atsju/capacitiveChess_HW/BOM/20210901_BOM_Capacitive chessboard.xlsx

Item | Designator | Quantity | Manufacturer | Part number | Description | Footprint | Type | Remark
1 | B1 | 1 | Keystone | 2468 | 2AAA battery holder | Non-standard | THD
2 | S129 | 1 | E-Switch | EG1206A | switch | Non-standard | THD
3 | S130, S131, S132, S133, S134 | 5 | Diptronics | DTS-62N-V | 6x6mm tact switch. Switch Push Button OFF (ON) SPST Round Button Momentary Contact PC Pins Thru-Hole | 6x6mm tact switch | THD | Assembly house often need part number for this even if it’s very common part. Just pick cheap one or with button head color/length you want.
4 | J1 | 1 | Amphenol ICC / FCI | 10118193-0001LF | FCI Right Angle Surface Mount Mount Female USB Connector; 100 V ac; 1.8A | Non-standard | SMD/THD
5 | C1, C2, C3, C4, C5, C6, C7, C8, C9, C10, C11, C12, C13, C14, C15, C16, C20, C23, C24, C25, C26, C27, C28, C33, C53, C54, C55, C56, C57, C59, C60 | 31 | - | 100nF | 0402 100nF 6.3V X5R | 0402 | SMD
6 | C17, C18, C21 | 3 | - | 1uF | 0603 1uF 10V X5R | 0603 | SMD
7 | C19 | 1 | - | 100uF | 1206 100uF 6.3V X5R | 1206 | SMD
8 | C29, C31 | 2 | - | 4.7uF | 0603 4.7uF 6.3V X5R | 0603 | SMD
9 | C30, C34, C61 | 3 | - | 10uF | 0603 10uF 6.3V X5R | 0603 | SMD
10 | C32 | 1 | - | 22pF | 0402 22pF 6.3V C0G | 0402 | SMD
11 | C35, C36 | 2 | - | 1nF | 0402 1nF 6.3V X5R | 0402 | SMD
12 | D1, D2, D3, D4, D5, D6, D7, D8, D9, D10, D11, D12, D13, D14, D15, D16, D17, D18, D19, D20, D21, D22, D23, D24, D25, D26, D27, D28, D29, D30, D31, D32, D33, D34, D35, D36, D37, D38, D39, D40, D41, D42, D43, D44, D45, D46, D47, D48, D49, D50, D51, D52, D53, D54, D55, D56, D57, D58, D59, D60, D61, D62, D63, D64, D65, D66, D67, D68, D69, D70, D71, D72, D73, D74, D75, D76, D77, D78, D79, D80, D81 | 81 | Lite-On | LTST-C230KRKT | bottom view LED Min distance is 2.2mm. Drill 2.4mm | 1206 | SMD | Requires manual drilling at home before mounting. Fab house will not assembly this for you with V0 PCB.
13 | D83 | 1 | Rohm | RSX051VAM30TR | Schottky diode, Vf<0.25V@10mA/25°C Vrrm>25V | SOD-323HE | SMD
14 | J2 | 1 | Amphenol ICC / FCI | SFV10R-1STBE1HLF | Conn FFC/FPC Connector SKT 10 POS 0.5mm Solder RA SMD Embossed T/R | Non-standard | SMD
15 | L1 | 1 | Bourns | SRN4026-4R7M | 4.7uH DCR<0.1R Isat>0.8A 4x4mm | 4x4mm | SMD
16 | L2 | 1 | Bourns | SRN4018-2R2M | 2.2uH DCR<0.1R Isat>0.4A 4x4mm | 4x4mm | SMD
17 | R65, R67 | 2 | - | 10k | 0402 10k 1 % | 0402 | SMD
18 | R49, R50, R51, R52, R53, R54, R55, R56, R57, R71 | 10 | - | 1k | 0402 1k 1% | 0402 | SMD | Value on LED lines can be adjusted to change brightness
19 | R58, R62, SB20, SB21, SB22, SB23, SB28, SB29, SB30, SB31, SB36, SB37, SB38, SB39, SB44, SB45, SB46, SB47 | 18 | - | 100k | 0402 100k 1% | 0402 | SMD
20 | R59 | 1 | - | 68k | 0402 68k 1% | 0402 | SMD
21 | R60 | 1 | - | 147k | 0402 147k 0.1% | 0402 | SMD
22 | R61 | 1 | - | 140k | 0402 140k 0.1% | 0402 | SMD
23 | SB16, SB17, SB18, SB19, SB24, SB25, SB26, SB27, SB32, SB33, SB34, SB35, SB40, SB41, SB42, SB43, SB48, SB49, SB50, | 19 | - | 0R | 0402 0R Solder Bridge Jumper, can be fitted with 0402 0R resistor for automated production or just closed with solder | 0402 | SMD
24 | U1, U2, U3, U4, U5, U6, U7, U8, U9, U10, U11, U12, U13, U14, U15, U16 | 16 | Microchip | MCP6043T-I/CH | 600 nA, Rail-to-Rail Input/Output Operational Amplifier, | SOT23-6 | SMD
25 | U17 | 1 | STMicroelectronics | STM32L4P5VGT6P | MCU 32-Bit ARM Cortex-M4F RISC 1MB Flash 1.71V to 3.6V | LQFP100 | SMD
26 | U18 | 1 | STMicroelectronics | USBLC6-2SC6 | USBLC6 Series 2 Line 6 V Uni / Bi-Directional ESD Protection | SOT23-6 | SMD
27 | U19 | 1 | Microchip | MIC5317-3.3YM5-TR | Single, High Performance 150mA LDO, 5 SOT-23 T/R | SOT23-5 | SMD
28 | U20 | 1 | Microchip | MCP1623T-I/CHY | Low-Voltage Input Boost Regulator , 175 mA, Input Voltage 0.65 to 5.5 V, Output Voltage 2.0 to 5.5 V, | SOT23-6 | SMD
29 | U21 | 1 | Texas Instruments | TPS62240DDCR | 2.25MHz 300mA Step-Down Converter in 2x2mm SON/TSOT23 Package 5-SOT-23-THIN -40 to 85 | SOT23-5 | SMD
30 | U22 | 1 | Texas Instruments | TS5A3166DBVR | Analog switch Ron<2R@3V | SOT23-5 | SMD
31 | B2 | 1 | Keystone | 2462 | 2AA battery holder | Non-standard | DNP | Solder one of B1 or B2
32 | C38 | 1 | - | 100nF | 0402 100nF 6.3V X5R | 0402 | DNP | Other screen Option
33 | C37, C39, C40, C41, C42, C43,C44, C45, C46, C47, C49, C50, C51, C52 | 14 | - | 2.2uF | 0603 2.2uF 25V X5R | 0603 | DNP | Other screen option
34 | C48 | 1 | - | 1uF | 0603 1uF 10V X7R | 0603 | DNP | Other screen option
35 | D82 | 1 | Rohm | RSX051VAM30TR | Schottky diode, Vf<0.25V@10mA/25°C Vrrm>25V | SOD-323HE | DNP | Other screen option
36 | FID1, FID2, FID3 | 3 | - | Fiducial | fiducial mark for assembly | - | DNP
37 | J3 | 1 | Samtec | FTSH-110-01-L-DV-007-K | Conn Shrouded Header HDR 20 POS 1.27mm Solder ST SMD Tube | Non-standard | DNP | Solder this to debug with J-Trace
38 | J4 | 1 | Amphenol ICC / FCI | 62684-401100ALF | Conn; Rect; FPC/FFC; 40Cnt; SMT; OPUSeries; ZIF; 0.5mmPitch; RtAngle | Non-standard | DNP | Other screen option
39 | Q1, Q2 | 2 | Infineon | BSS308PEH6327 | MOSFET P-CH RdsOn<0.5R VGSth<2.5V | SOT23-5 | DNP | Other screen option
40 | Q3, Q4, Q5 | 3 | Nexperia | 2N7002NXAKR | 60 V, single N-channel Trench MOSFET | SOT23-3 | DNP | Other screen option
41 | R1, R2, R3, R4, R5, R6, R7, R8, R9, R10, R11, R12, R13, R14, R15, R16, R17, R18, R19, R20, R21, R22, R23, R24, R25, R26, R27, R28, R29, R30, R31, R32, R33, R34, R35, R36, R37, R38, R39, R40, R41, R42, R43, R44, R45, R46, R47, R48, R63, R64, R66, R68 | 52 | - |  |  | 0402 | DNP
42 | R69 | 1 | - | 33k | 0402 33k 1% | 0402 | DNP | Other screen option
43 | R70 | 1 | - | 2k | 0402 2k 1% | 0402 | DNP | Other screen option
44 | S1, S2, S3, S4, S5, S6, S7, S8, S9, S10, S11, S12, S13, S14, S15, S16, S17, S18, S19, S20, S21, S22, S23, S24, S25, S26, S27, S28, S29, S30, S31, S32, S33, S34, S35, S36, S37, S38, S39, S40, S41, S42, S43, S44, S45, S46, S47, S48, S49, S50, S51, S52, S53, S54, S55, S56, S57, S58, S59, S60, S61, S62, S63, S64, S65, S66, S67, S68, S69, S70, S71, S72, S73, S74, S75, S76, S77, S78, S79, S80, S81, S82, S83, S84, S85, S86, S87, S88, S89, S90, S91, S92, S93, S94, S95, S96, S97, S98, S99, S100, S101, S102, S103, S104, S105, S106, S107, S108, S109, S110, S111, S112, S113, S114, S115, S116, S117, S118, S119, S120, S121, S122, S123, S124, S125, S126, S127, S128 | 128 | - | sense_cap_chess_20mm | 20x20mm sensing footprint | - | DNP | This is PCB copper
45 | SB1, SB2, SB3, SB4, SB5, SB6, SB7, SB8, SB9, SB10, SB11, SB12, SB13, SB14, SB15, SB51 | 16 | - |  | Solder bridge LEAVE OPEN | 0402 | DNP
46 | screenB | 1 | Pervasive Displays | E2144CS021 | pervasive displays EPD screen with eTC driver 1,44inch | Non-standard | DNP | Other screen option
47 | screenA | 1 | Sharp | LS013B7DH03 | sharp memory LCD 3V | Non-standard | assembly | If difficult to buy, can be harvested on some eval board/kit like BOOSTXL-SHARP128 or siliconlabs SLWSTK
48 | rubberFeet | 8 | Essentra | RBS-34 | mounting fixings bumper | Non-standard | assembly
