atsju/capacitiveChess_HW/Capacitive chessboard.PDF

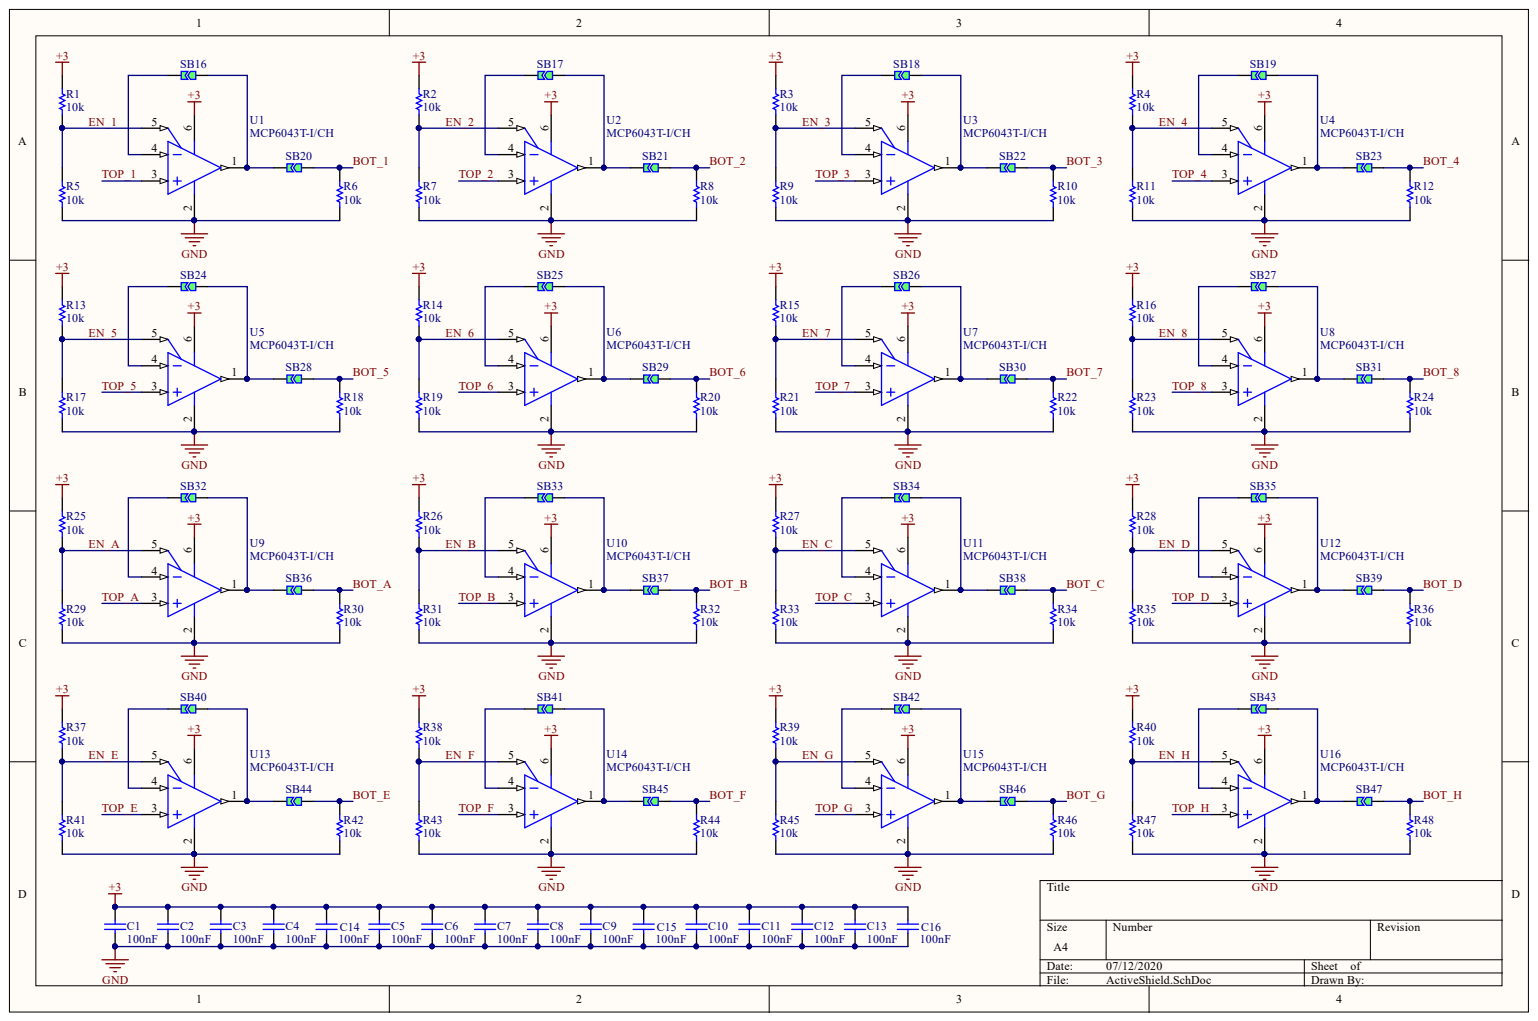
[picture p1: page 1]

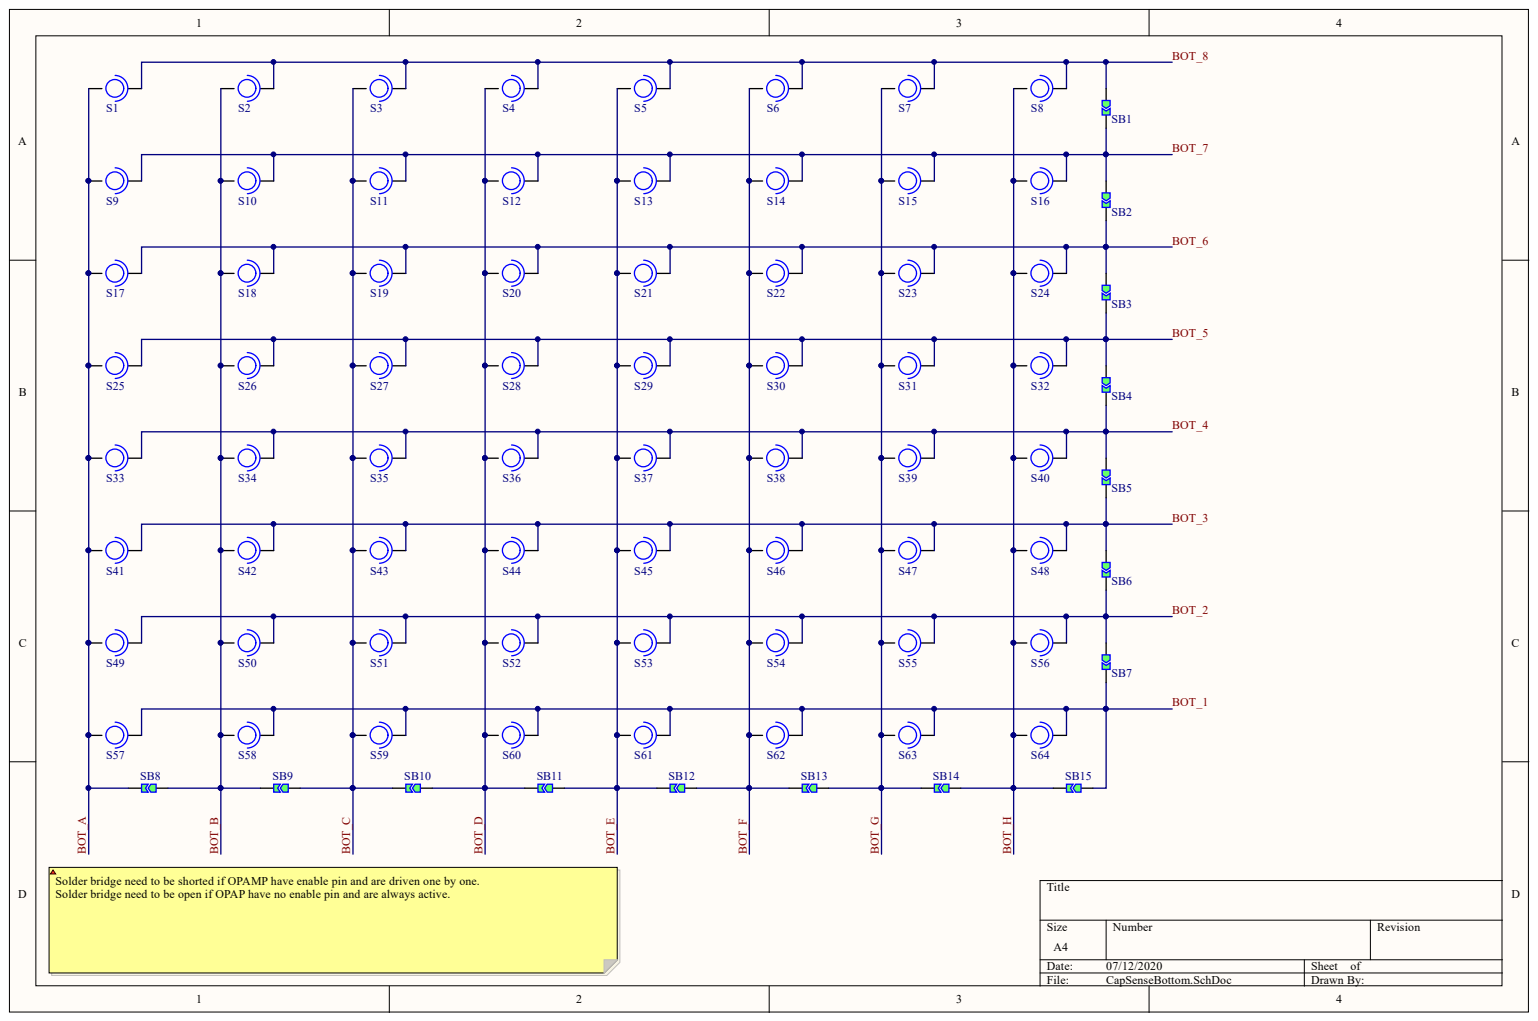
[picture p2: page 2]
File:; CapSenseBottom.SchDoc; Drawn By:

Solder bridge need to be shorted if OPAMP have enable pin and are driven one by one.
Solder bridge need to be open if OPAP have no enable pin and are always active.

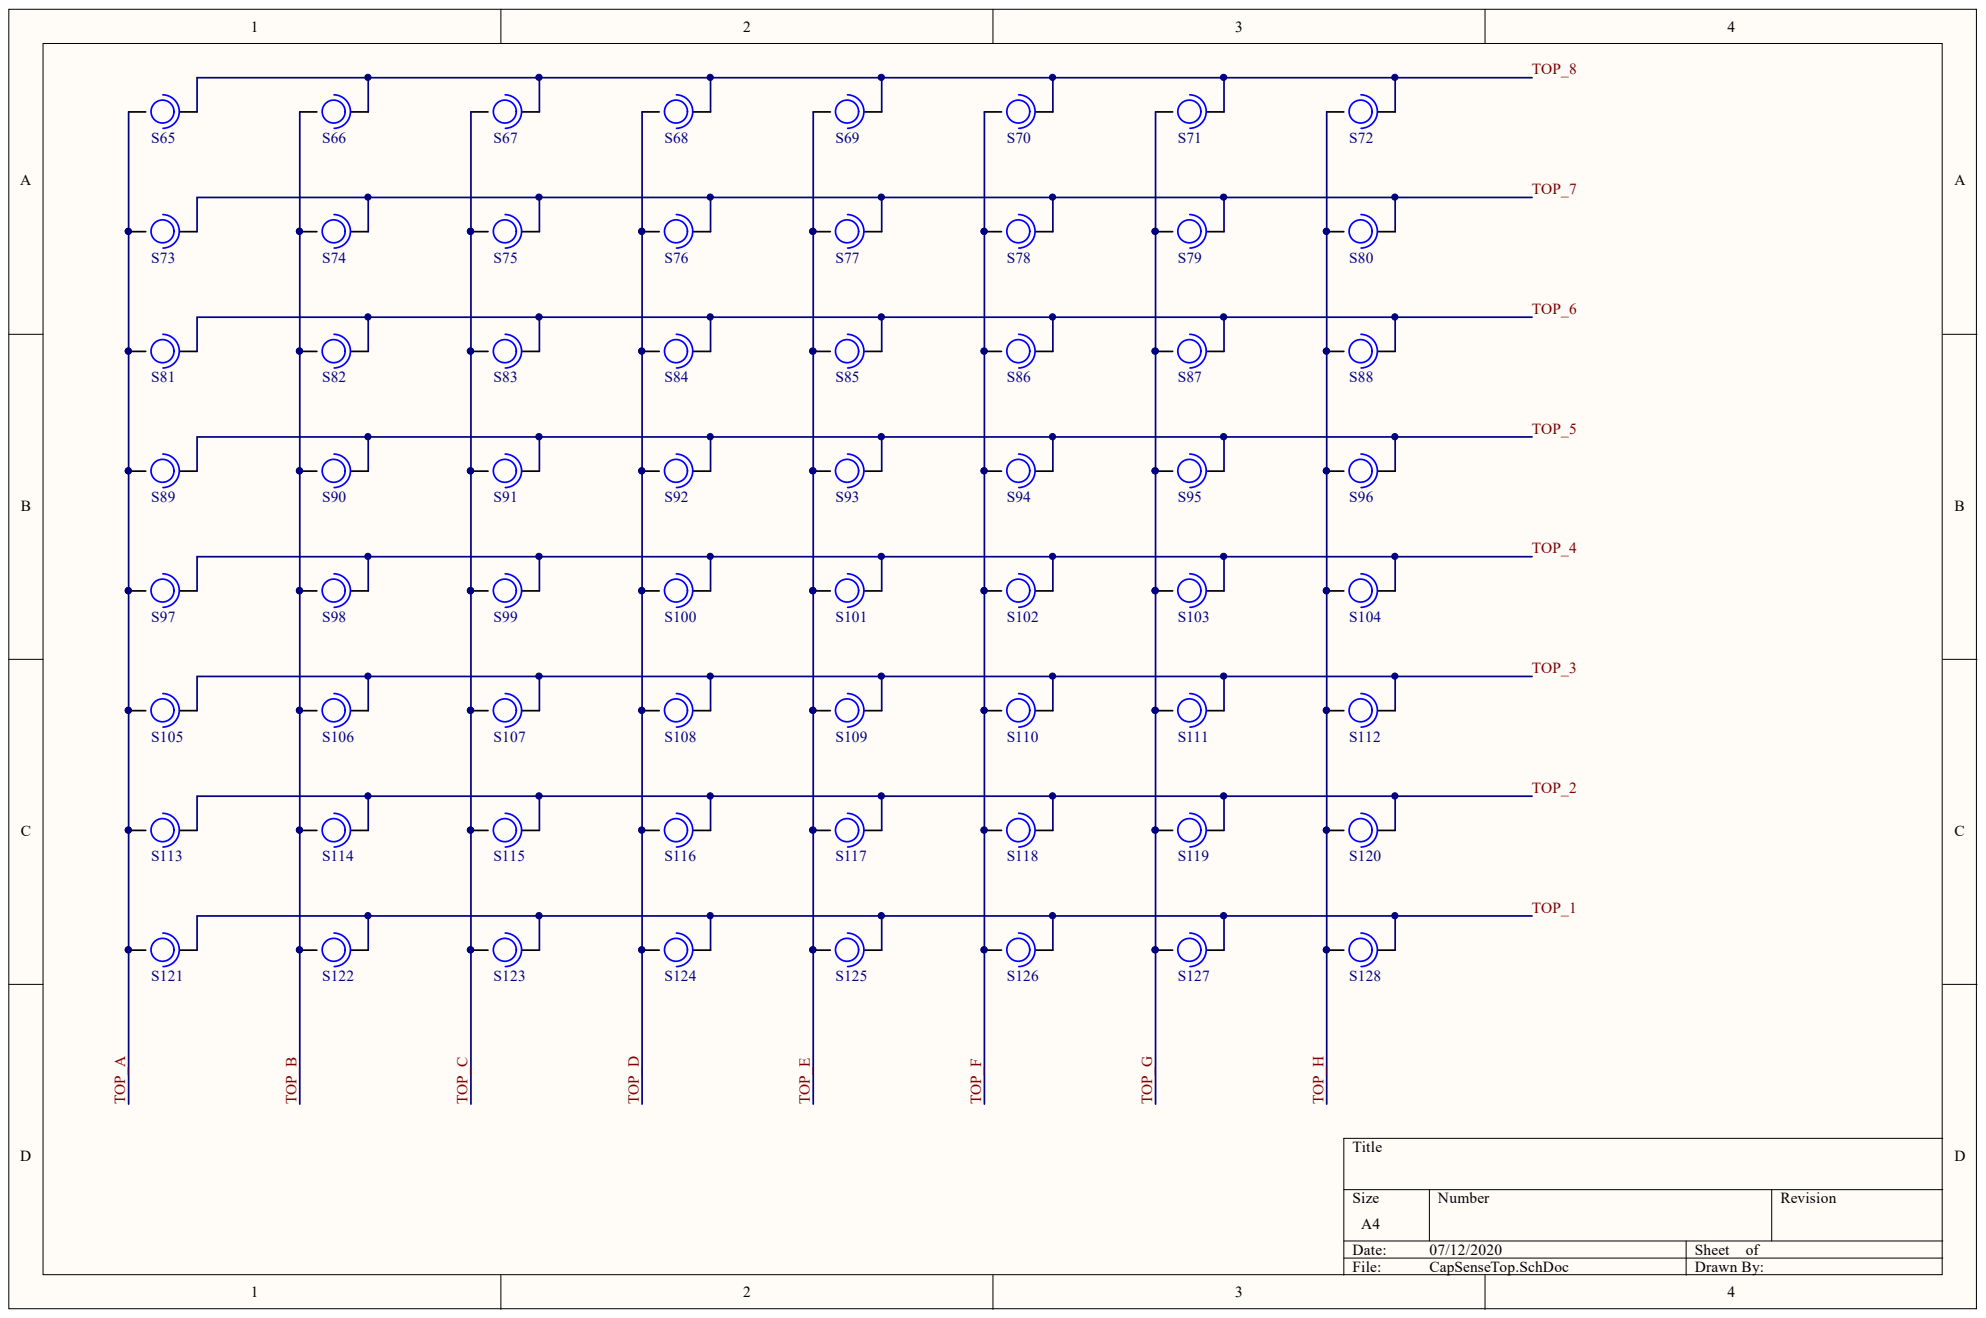
[picture p3: page 3]
File:; CapSenseTop.SchDoc; Drawn By:

COS74 | COS75 S75 | COS76 S76 | COS77 S77 | COS78 S78 | COS79

COS82 | COS83 S83 | COS84 S84 | COS85 S85 | COS86 S86 | COS87

COS90 | COS91 S91 | COS92 S92 | COS93 S93 | COS94 S94 | COS95

COS98 | COS99 S99 | COS100 S100 | COS101 S101 | COS102 S102 | COS103

COS106 | COS107 S107 | COS108 S108 | COS109 S109 | COS110 S110 | COS111

COS114 | COS115 S115 | COS116 S116 | COS117 S117 | COS118 S118 | COS119

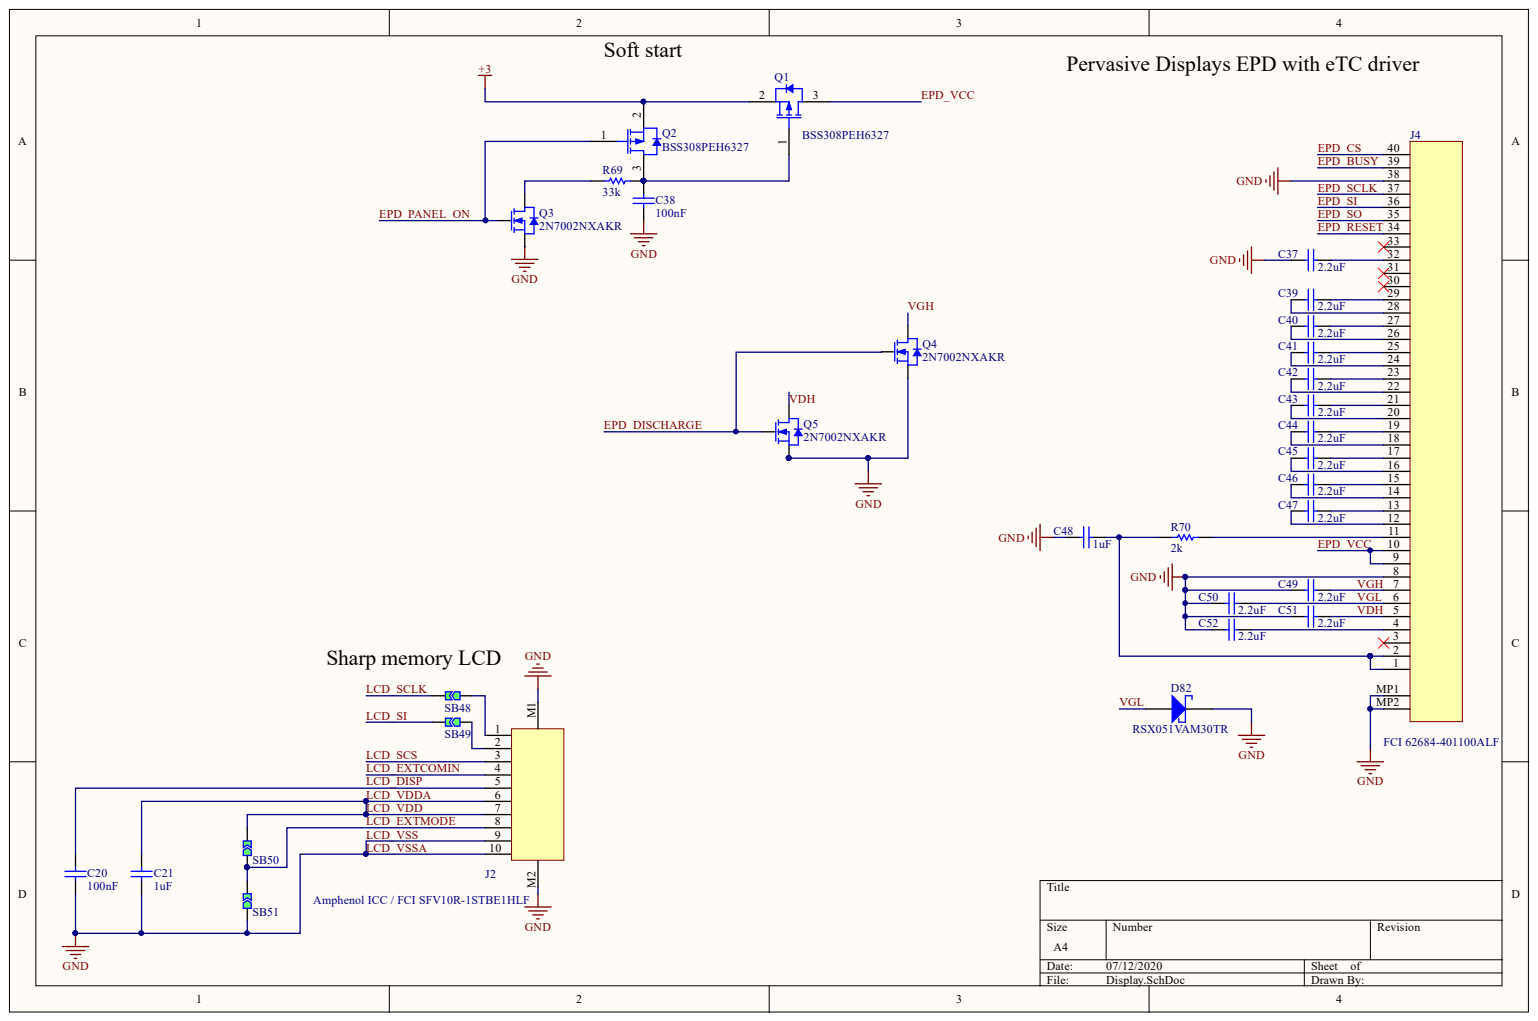
[picture p4: page 4]

VGH | | 7

C50 | | | 2.2uF VGL | 6

2.2uF C51 | VDH | 5

LCD_VDDA | 6
LCD_VDD | 7
LCD_EXTMODE | 8
LCD_VSS | 9
LCD_VSSA | 10

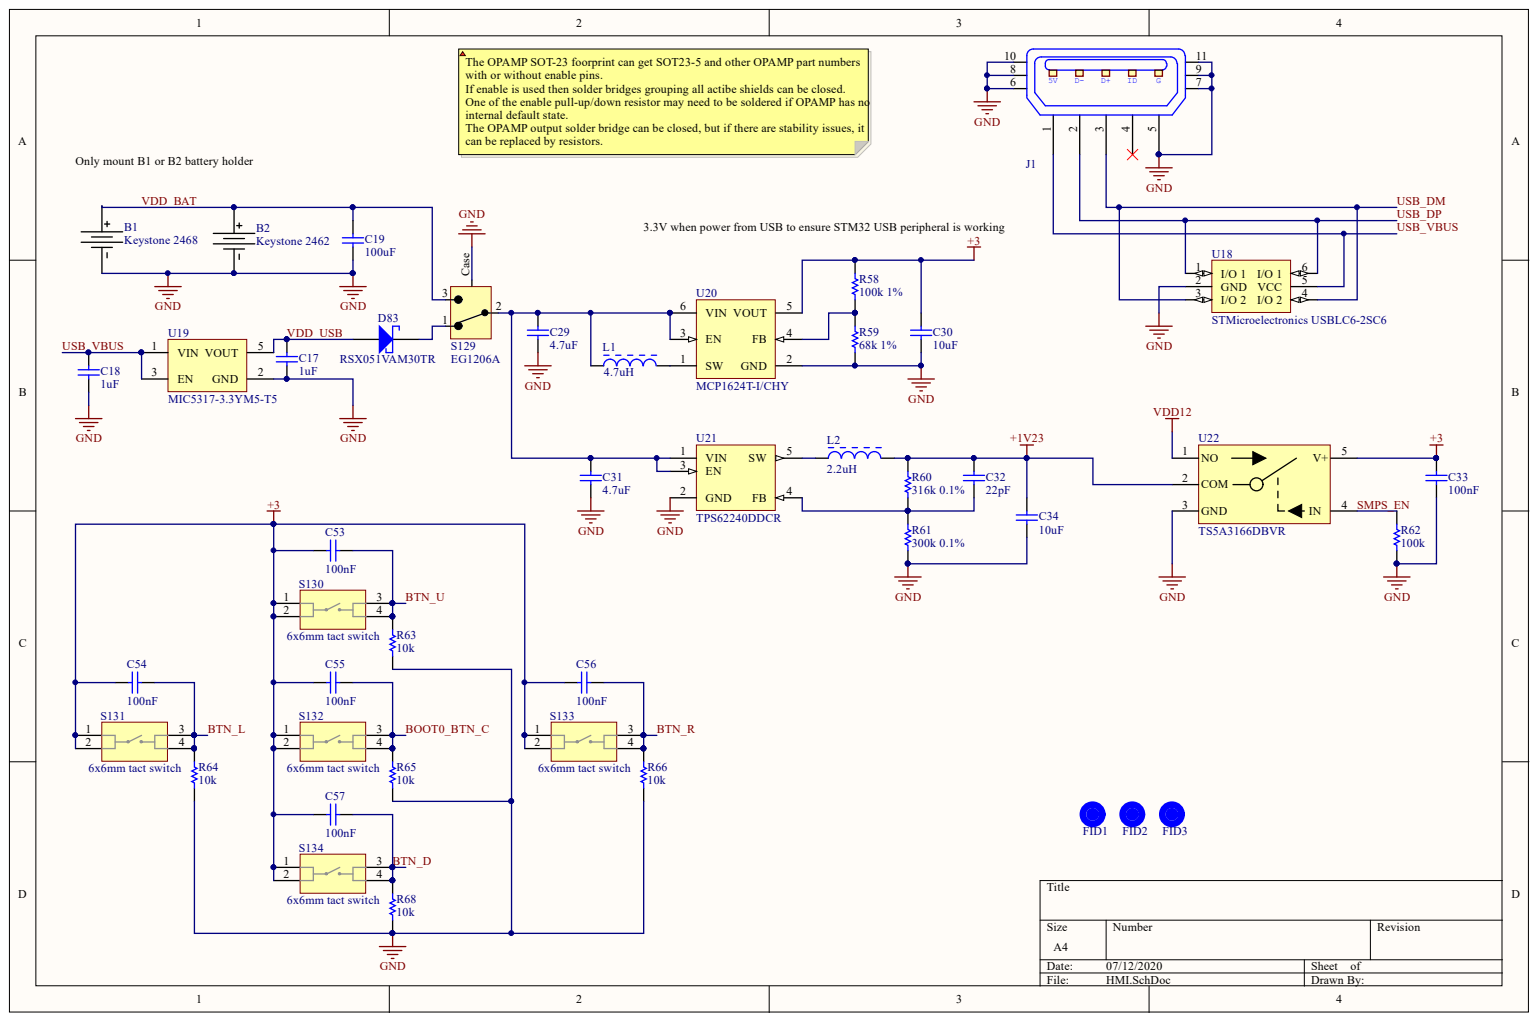
[picture p5: page 5]

The OPAMP SOT-23 foorprint can get SOT23-5 and other OPAMP part numbers
with or without enable pins.
If enable is used then solder bridges grouping all actibe shields can be closed.
One of the enable pull-up/down resistor may need to be soldered if OPAMP has no
internal default state.
The OPAMP output solder bridge can be closed, but if there are stability issues, it
can be replaced by resistors.

Only mount B1 or B2 battery holder

3.3V when power from USB to ensure STM32 USB peripheral is working

BTN_D

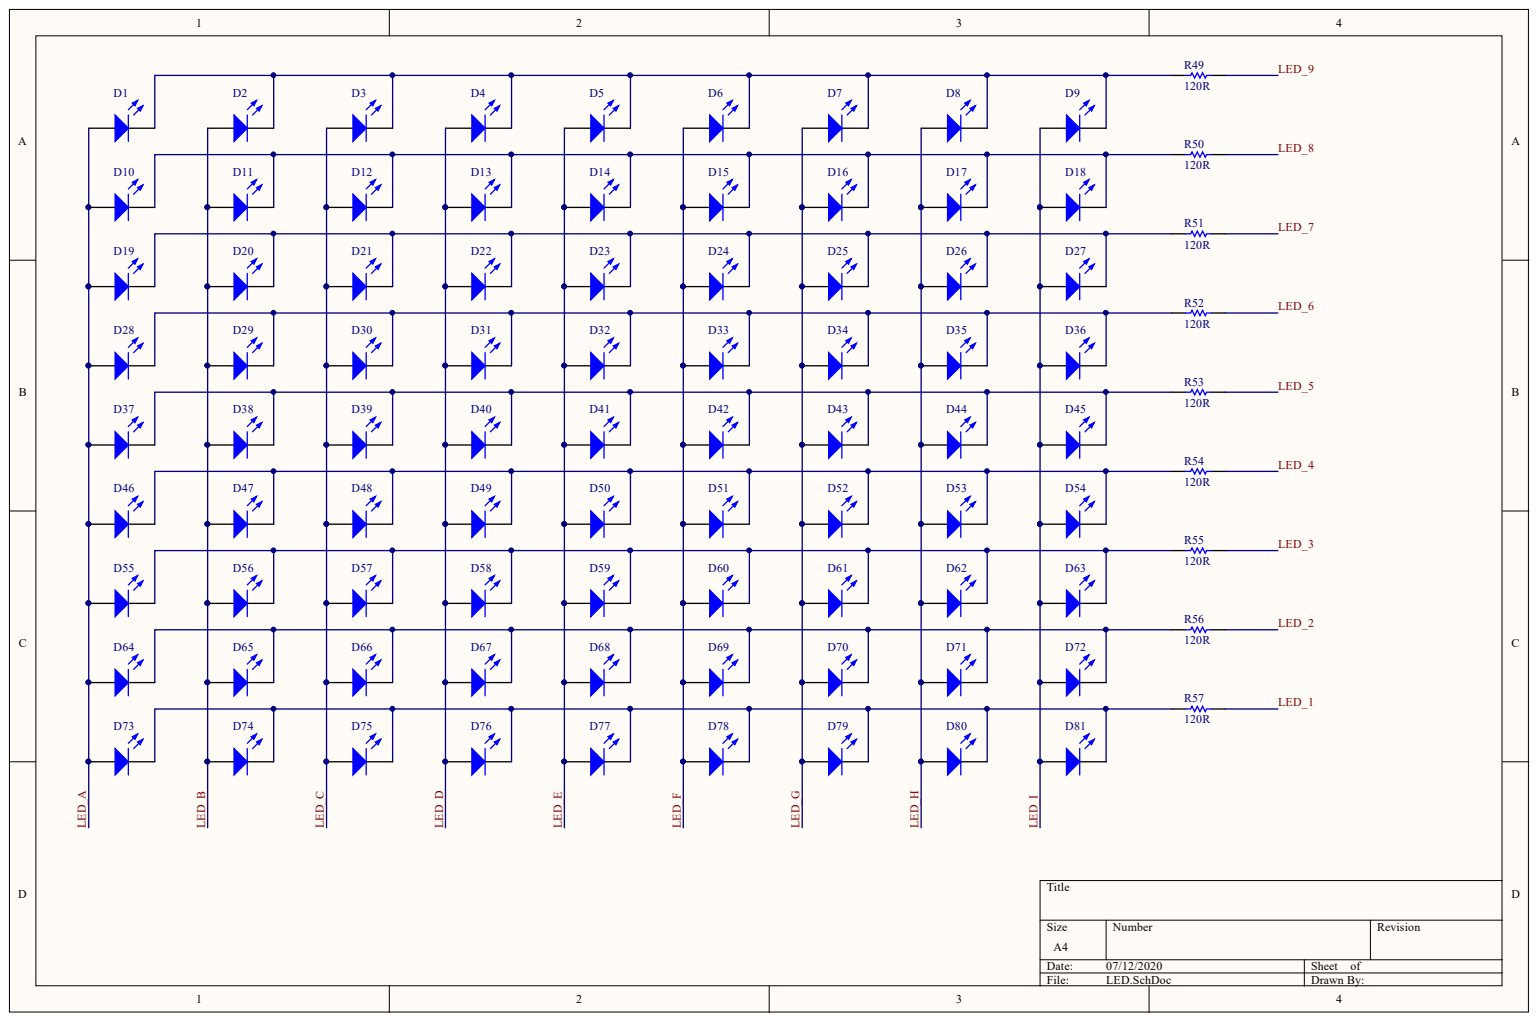
[picture p6: page 6]

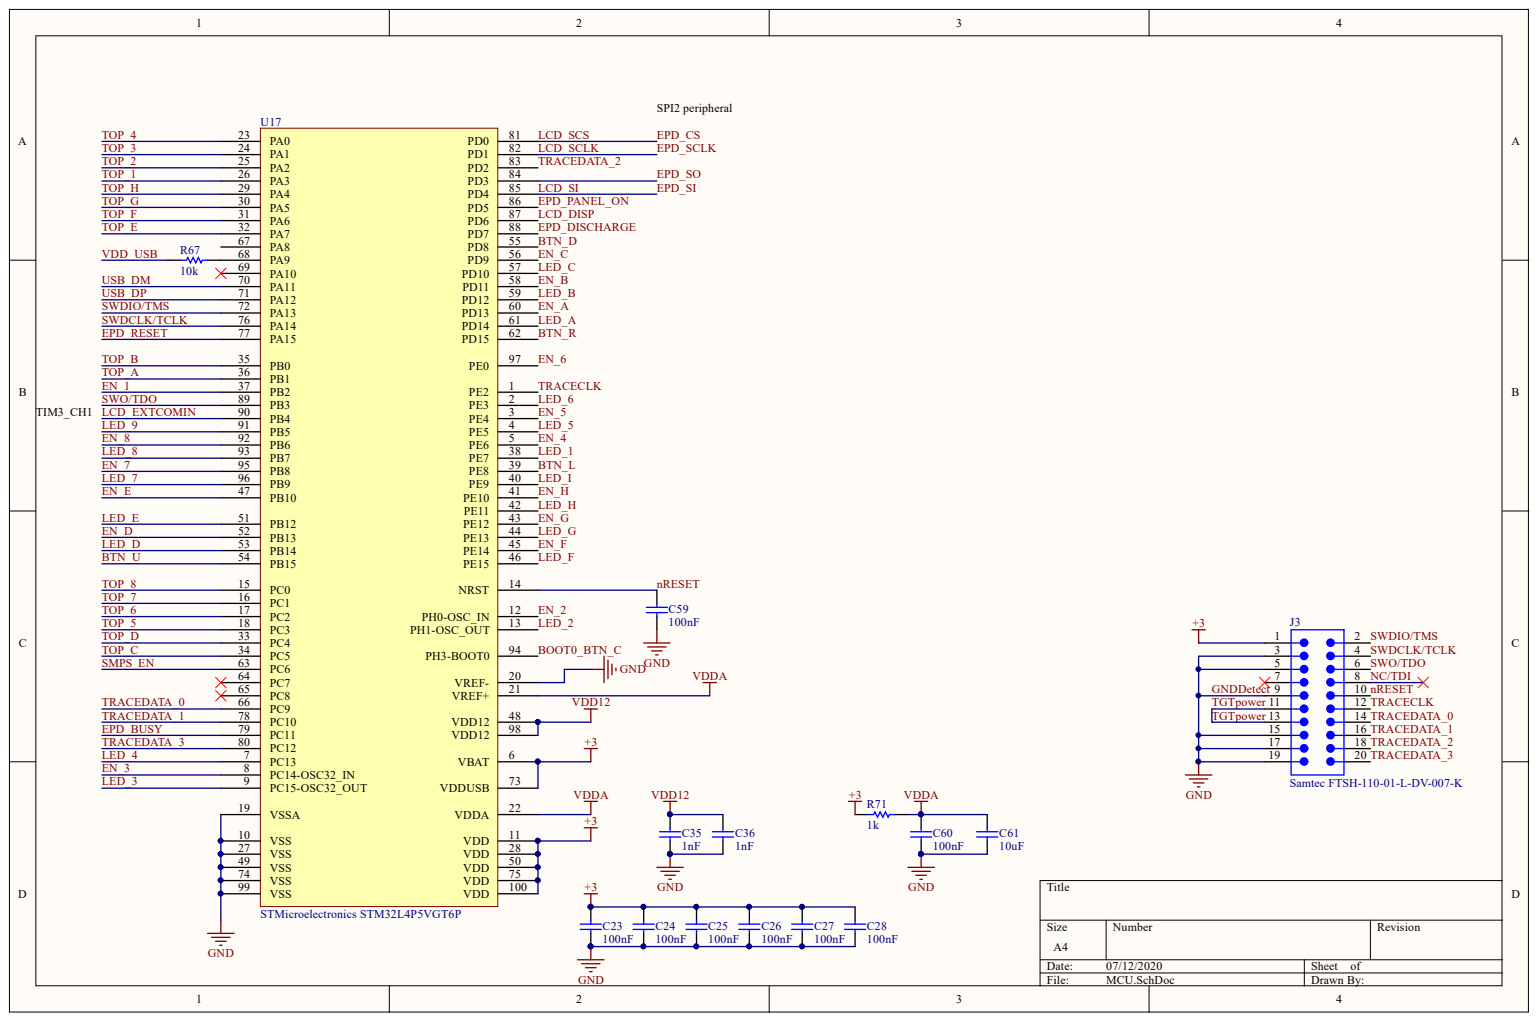
[picture p7: page 7]
Sheet o; ics STM3; Samtec FTSH-1; +3 GND; SPI2 peri

G N D Detect | 7

2 7 | 2 8
4 9 | 5 0
7 4 | 7 5

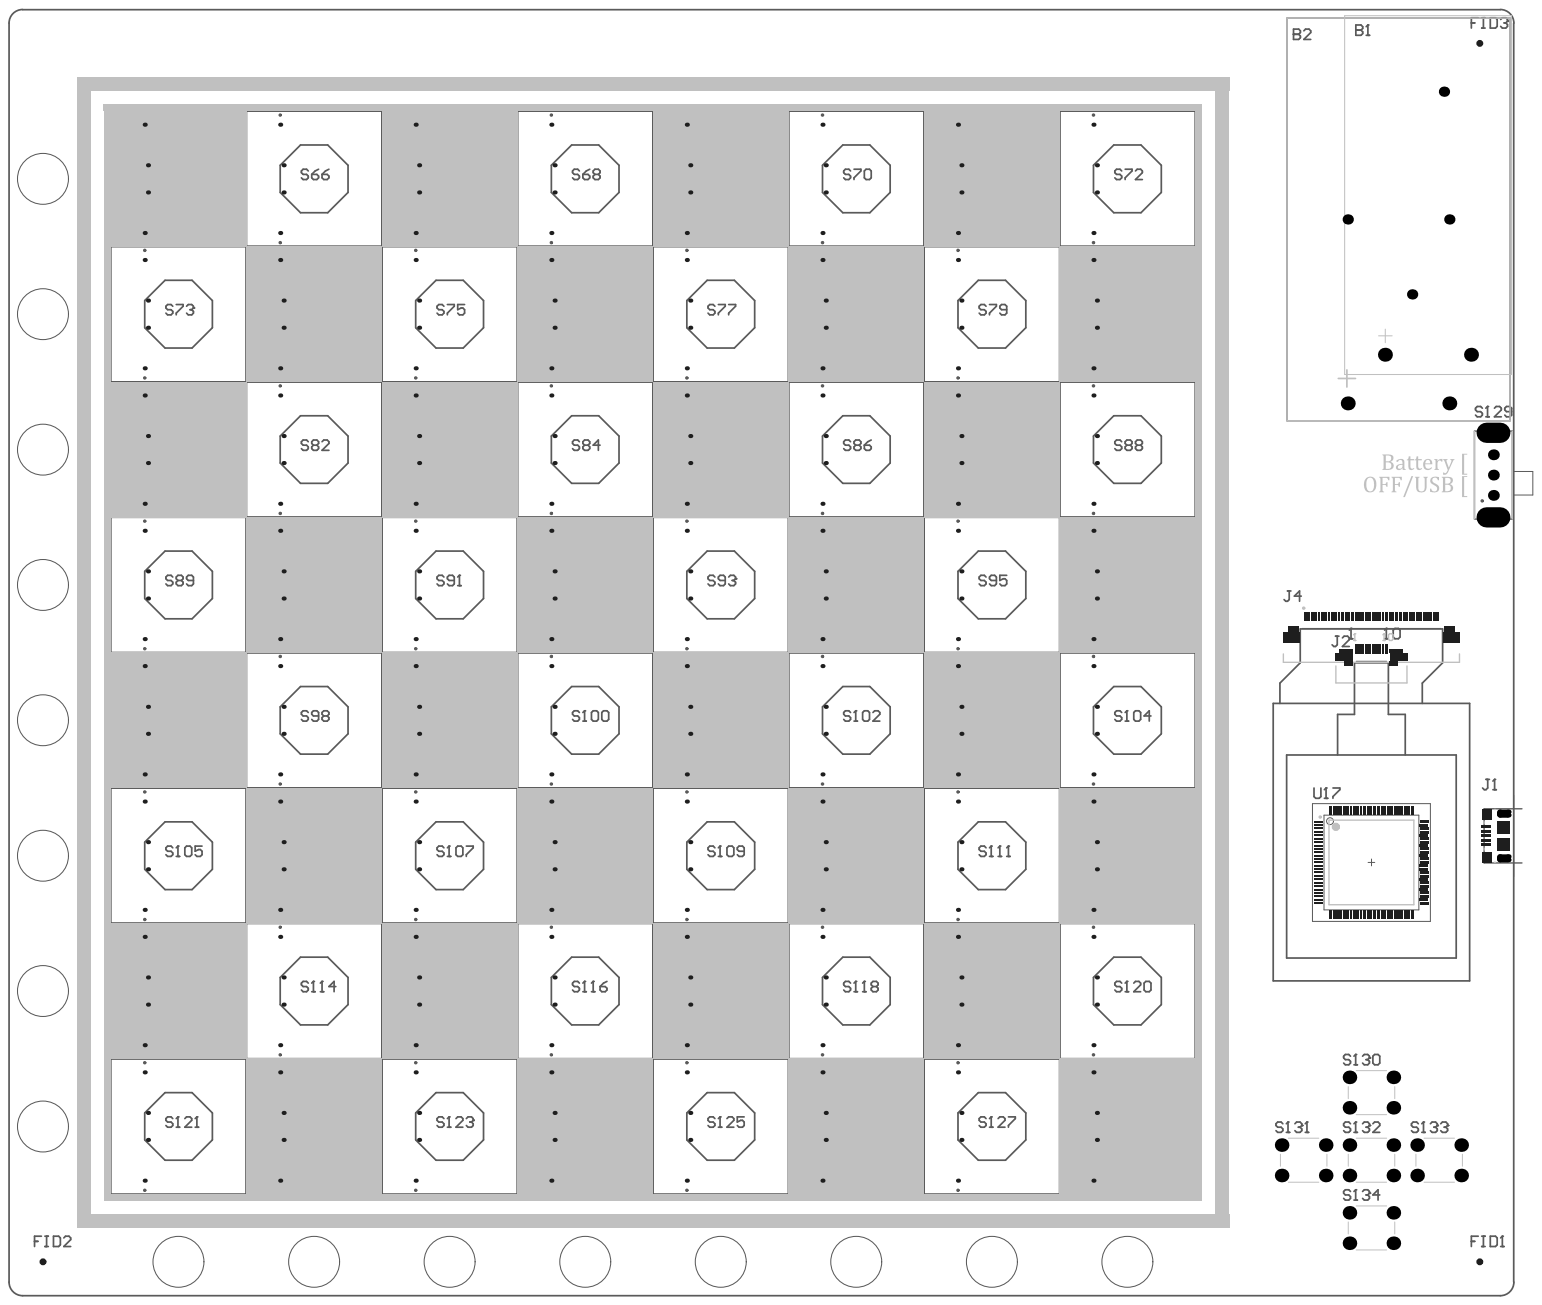
[picture p8: page 8]

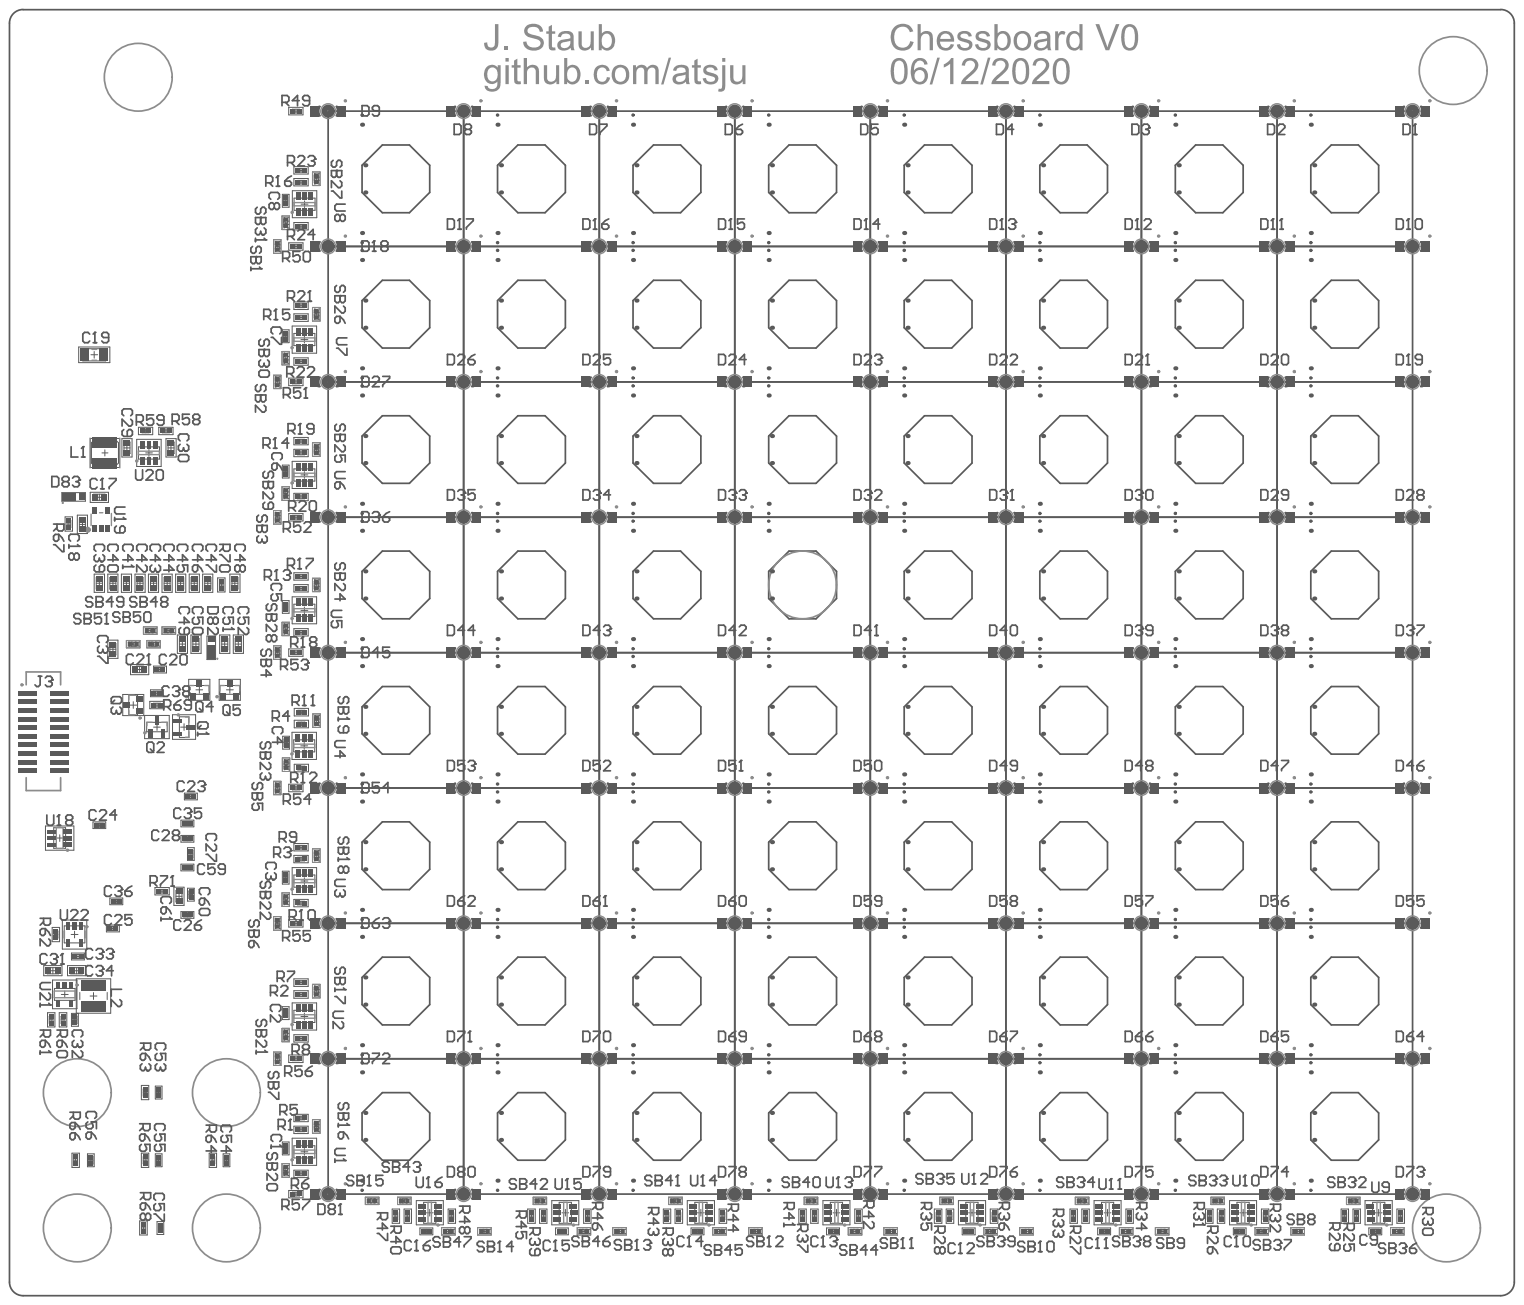
[picture p9: page 9]
