atsju/capacitiveChess_HW/(commit log)

2021-01-09 add HW_V0 files
    [20210901_BOM_Capacitive chessboard.xlsx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]
2021-01-09 correct BOM
    [20210901_BOM_Capacitive chessboard.xlsx]
2021-01-11 correct typo in BOM
    [20210901_BOM_Capacitive chessboard.xlsx]
